agwillfu/PetToilet/04_AppStore/review-notes.txt

NO HARDWARE OR ACCOUNT NEEDED TO REVIEW THIS APP

On a fresh install the app opens directly into a built-in simulation mode.
It runs the same state machine as the physical device entirely on-device and
generates simulated pet-visit events on a timer, so every feature is fully
exercisable without hardware, account, or network: live status (idle /
in-use / flushing / cooldown), manual flush, all three threshold sliders,
scheduled cleaning, activity log, and diagnostics.

The first simulated event occurs about 12 seconds after launch, then repeats
every 45-110 seconds. Just open the app and wait.

This is not a trial or feature-limited build. It is an offline mode; the full
feature set is available for review at all times.

There is no account registration, login, or deletion; no purchases or
subscriptions; no user-generated content; and the app requests no sensitive
data or device permissions.

DEMONSTRATION VIDEOS
Recorded on a physical iPhone 14 Pro running iOS 26.6.1:
App walkthrough (41s): https://agwillfu.github.io/PetToilet/demo-app.mp4
Driving the real hardware (22s): https://agwillfu.github.io/PetToilet/demo-hardware.mp4

WHAT THE APP DOES
PetToilet is a companion app for a self-built pet toilet device based on an
ESP8266 microcontroller. A vibration sensor detects when the dog steps on and
off the pad; the device waits until the dog has fully left, then runs a water
pump to flush. Flushing while the dog is still on the pad would startle it.
The app shows live status, flushes manually, tunes detection thresholds,
configures scheduled cleaning, and shows two weeks of activity.

Audience: owners of this self-built device. Firmware, wiring diagram and build
instructions are open source: https://github.com/agwillfu/PetToilet

To connect real hardware (not needed for review), the user enters their own
Adafruit IO credentials via the gear icon in the top left.

DEVICES TESTED
iPhone 14 Pro, iOS 26.6.1 (physical device)
iPhone 17 Pro / 17 Pro Max simulators, iOS 26.5

EXTERNAL SERVICES
Adafruit IO (https://io.adafruit.com) is the only external service, used as an
MQTT broker so the phone and the microcontroller can exchange messages while
both are behind consumer NAT:
- wss://io.adafruit.com/mqtt (TLS) for live status and commands
- https://io.adafruit.com/api/v2/... to read the user's own history

Each user connects with their own Adafruit IO account. The developer operates
no server and has no access to any user's data or credentials.

There are no analytics providers, advertising networks, payment processors, AI
services, authentication services, or third-party SDKs. The MQTT client is
implemented in the app itself; there are zero third-party dependencies.

REGIONAL DIFFERENCES
None. The app functions identically in all regions, with no region-specific
content, pricing or feature gating. The interface is Traditional Chinese only;
times use the device's own time zone and a 24-hour clock.

REGULATED INDUSTRY / THIRD-PARTY MATERIAL
Not a regulated industry. No protected third-party material: the app icon and
interface graphics are original work, interface symbols are Apple's SF Symbols,
and all displayed data is generated either by the simulation mode or by the
user's own device.
