agwillfu/PetToilet/04_AppStore/screenshots/1_status.png

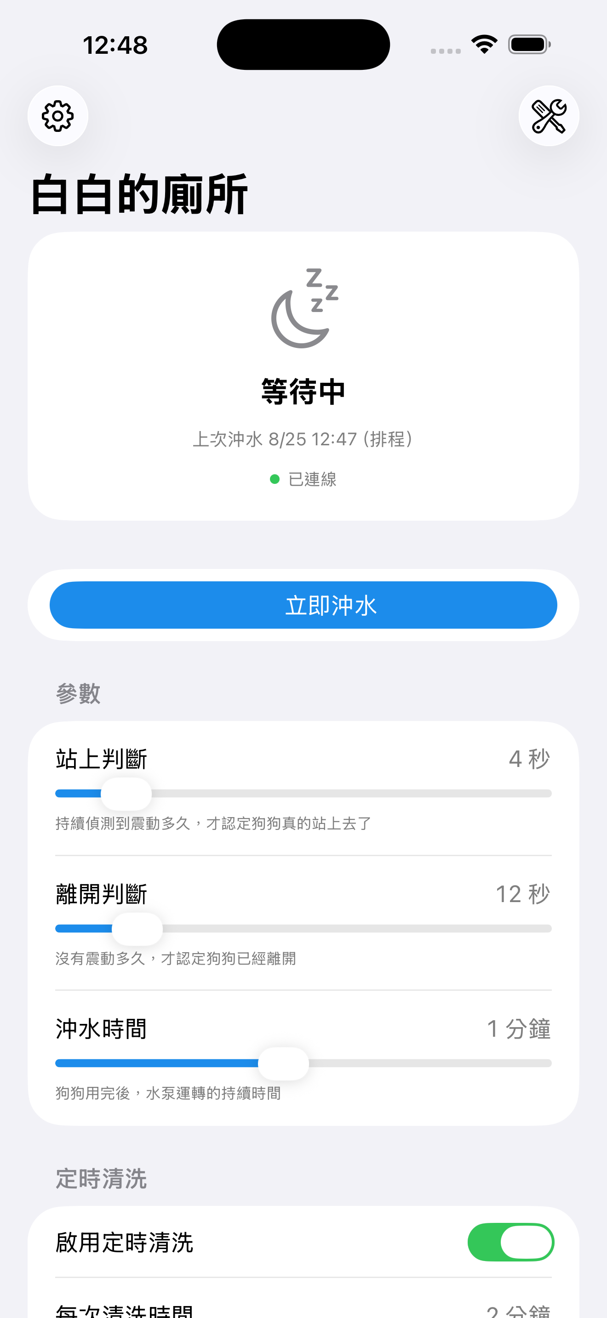
04_AppStore/screenshots/1_status.png
