agwillfu/PetToilet/04_AppStore/screenshots/2_settings.png

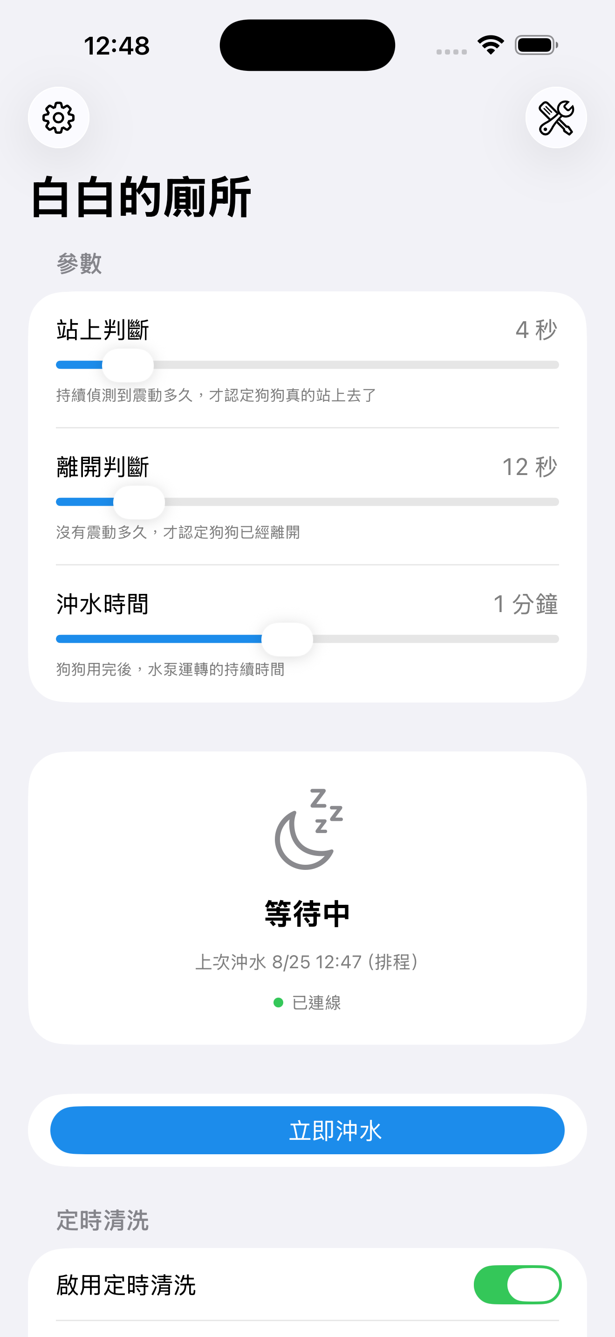
04_AppStore/screenshots/2_settings.png
