agwillfu/PetToilet/04_AppStore/screenshots/3_schedule.png

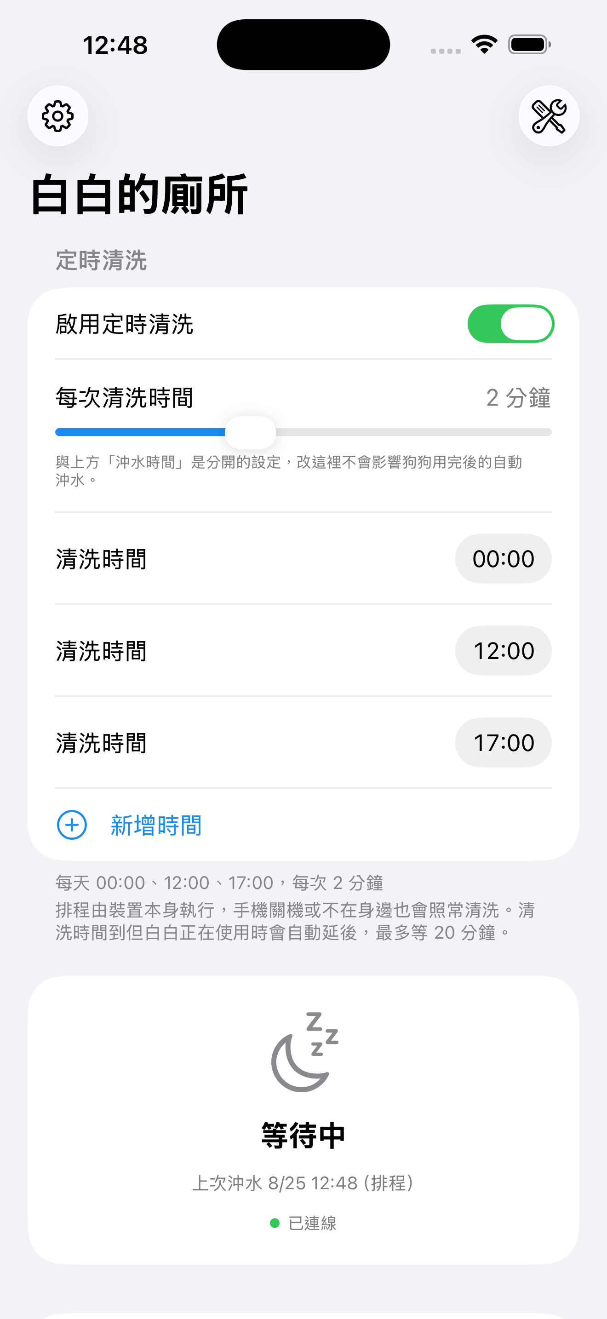
04_AppStore/screenshots/3_schedule.png
