agwillfu/PetToilet/04_AppStore/screenshots/4_activity.png

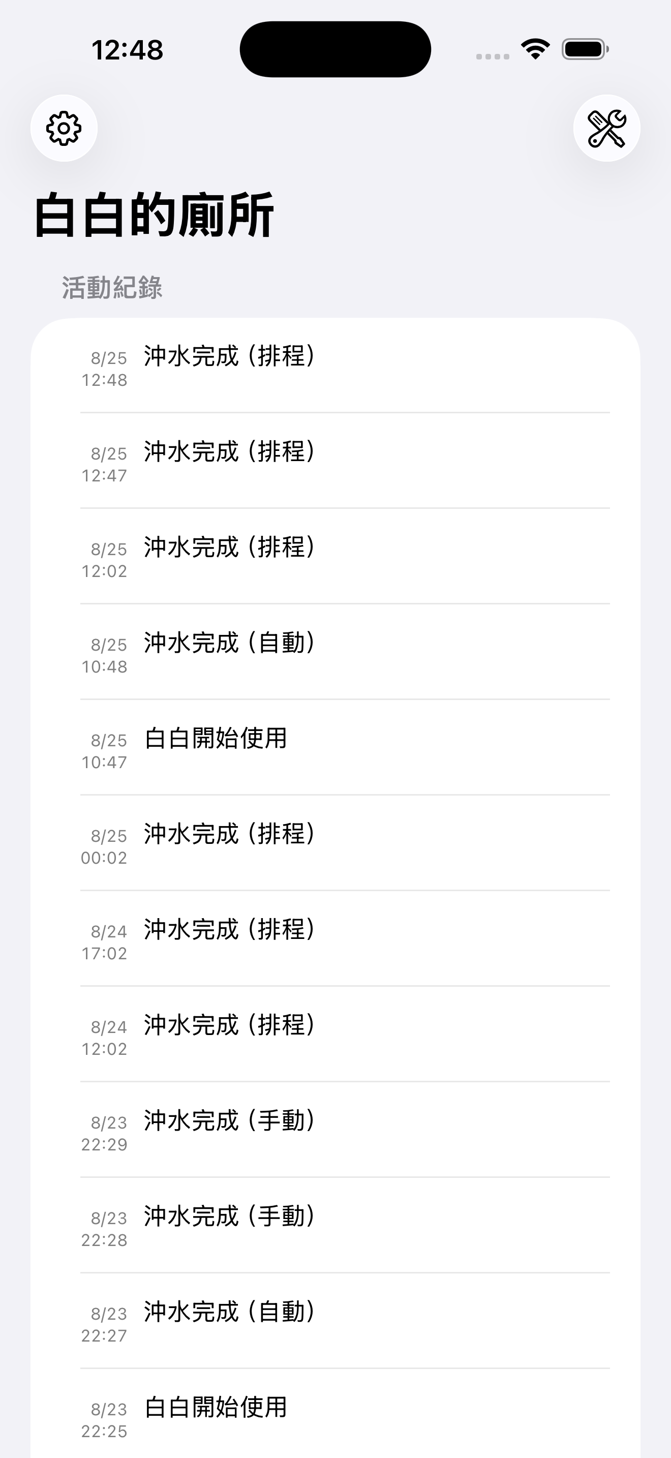
04_AppStore/screenshots/4_activity.png
