agwillfu/PetToilet/01_Arduino/PetToilet/certs.h

#pragma once
/*
 * DigiCert Global Root G2 — Adafruit IO (io.adafruit.com) 的根憑證
 *
 * 憑證鏈： *.adafruit.com  <-  GeoTrust TLS RSA CA G1  <-  DigiCert Global Root G2
 * 有效期： 2013-08-01 ~ 2038-01-15
 * SHA256： CB:3C:CB:B7:60:31:E5:E0:13:8F:8D:D3:9A:23:F9:DE:47:FF:C3:5E:43:C1:14:4C:EA:27:D4:6A:5A:B1:CB:5F
 *
 * 來源：macOS 系統信任庫 (SystemRootCertificates.keychain)，非從網路下載。
 * 已用 `openssl verify` 確認可驗證 io.adafruit.com 的憑證鏈。
 *
 * 注意：這裡釘住的是「根憑證」而非葉憑證指紋。Adafruit 的葉憑證約每半年更換
 * （目前這張 2027-01-28 到期），釘指紋會導致裝置每半年失聯一次。
 */

static const char DIGICERT_GLOBAL_ROOT_G2[] PROGMEM = R"CERT(
-----BEGIN CERTIFICATE-----
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
MrY=
-----END CERTIFICATE-----
)CERT";
