agwillfu/PetToilet/(commit log)

2026-08-25 初始提交：寵物尿盆自動沖水與行為監控系統
    韌體（ESP8266 + Adafruit IO）
    - 非阻塞狀態機，與網路完全解耦：斷網時沖水功能照常運作
    - MQTT over TLS，啟用 MFLN 把接收緩衝區從 16KB 壓到 512B
    - 定時清洗排程，狗狗使用中會自動延後
    - ArduinoOTA 無線更新，首次燒錄後不需再接 USB
    iOS App（SwiftUI，Swift 6 嚴格並發，零第三方相依）
    - 自製 MQTT 3.1.1 over WebSocket 用戶端
    - Demo 模式：完整重現韌體狀態機，無硬體也能操作所有功能
    - 活動紀錄從 Adafruit IO 回填歷史，本機保留兩週
    工具
    - ota.py 一鍵無線更新（含網段檢查）
    - mfln_probe.py 測試 broker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
    [Blink.ino, PetToilet.ino, certs.h]
2026-08-25 更新 README 狀態表：加入專案連結與上架素材進度
2026-08-26 上架文案：移除示範影片連結，改為模擬模式為主的審查說明
2026-08-29 README：v1.0.0 已提交 App Store 審查
2026-08-29 README：修正過時的韌體版本與 feed 數量
2026-08-30 上架：Guideline 2.1 資訊索取的回覆內容
2026-08-30 上架素材：加入審查用示範影片
    Apple 以 Guideline 2.1（Information Needed）要求提供實機錄影。
    - docs/demo-app.mp4 App 操作流程，41 秒
    - docs/demo-hardware.mp4 實體裝置運作，22 秒
    原始錄影是 HEVC，桌機版 Chrome 與 Firefox 多半播不動，
    一律轉成 H.264 才發布。原始檔留在本機，不進版控。
2026-08-30 上架素材：回覆內容壓縮至 4000 字元上限內
2026-09-19 建置編號 1 → 2，並備妥 App 審查備註
    Apple 回覆資料已收到，但版本在退件後不再是可審查狀態，
    必須上傳新 build 才能重新進入審查佇列。
    同一個行銷版本內重新上傳，建置編號必須遞增，否則 App Store Connect
    會直接拒收。行銷版本維持 1.0.0。
    04_AppStore/review-notes.txt 是這次要填進「App 審查資訊 → 備註」的
    內容（3.7KB，在 4000 bytes 上限內）。Apple 明確要求把這些說明放在
    該欄位供日後送審使用，避免重複收到同樣的資訊索取。
